collegefishies/yb-boy/imgs/code/analogPins.png

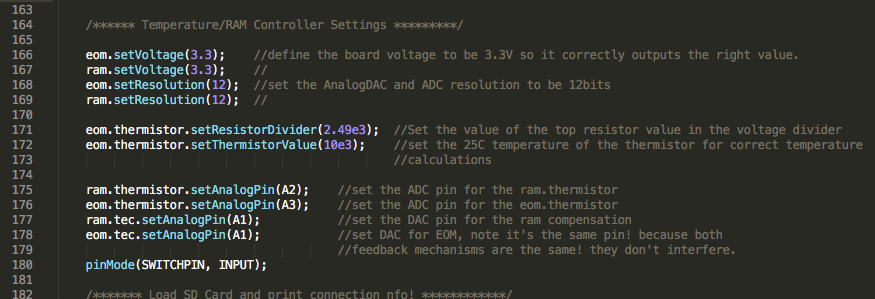
imgs/code/analogPins.png
