collegefishies/yb-boy/imgs/code/controller_classes.png

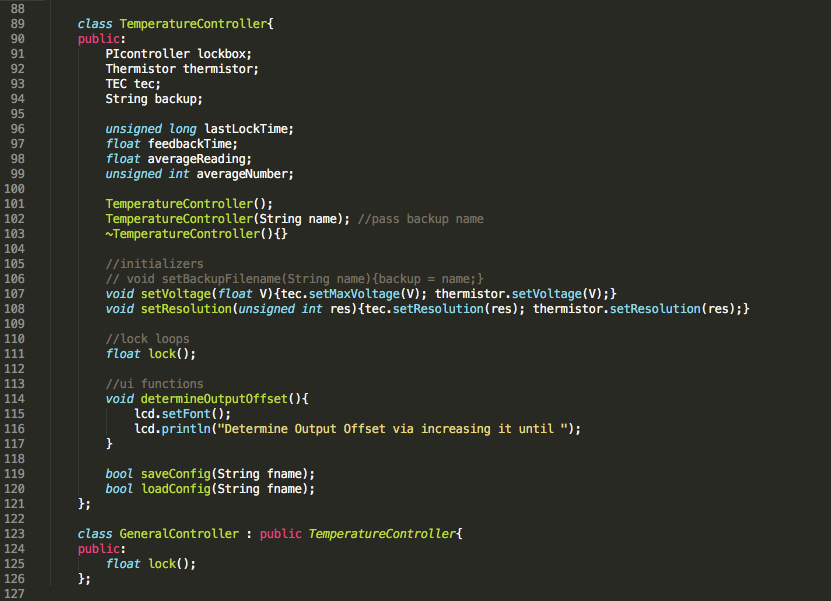
imgs/code/controller_classes.png
