collegefishies/yb-boy/(threads)

Thread 1 (2019-06-03):

Continuity Issue with commit b8b2317da

collegefishies, 2019-06-03:
Switching from TMP mode to RAM mode doesn't properly preserve continuity.

Initial drive was 3V after switching it jumped to 5.98V. Switching back from RAM to TMP preserved that 5.98V drive.

I need to correct continuity for the temperature to ram compensation switch.

collegefishies, 2019-06-05:
Fixed continuity branch and implemented into v1.x in commit 23eb9b72d50893243ce58777a3b49c2b77cd8568

Closed 2019-06-05.
