collegefishies/yb-boy/Yb-boy-build-instructions.pdf

T

I

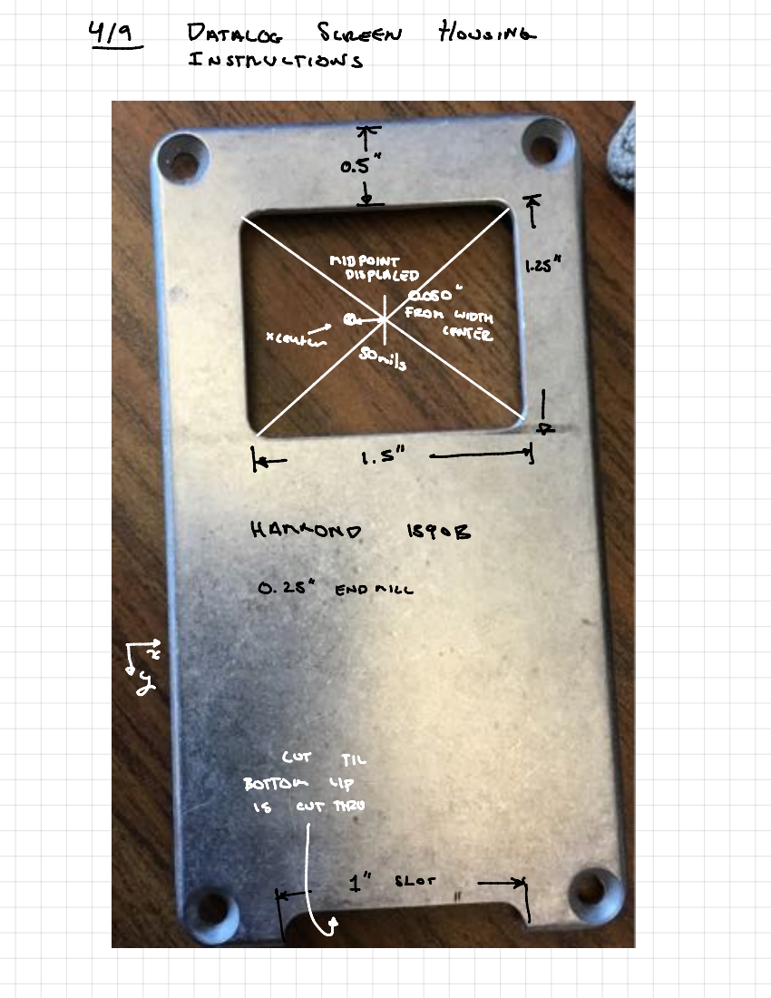
[picture p6: page 1]
DATALOG; SCREEN; HOUSING; Instructions; MIDPOINT; DISPLACED; FROM; WIDTH; CENTER center; HAMMOND; END; MILL; CUT; TIL; BOTTOM; LIP µIS; THZU; shot -4

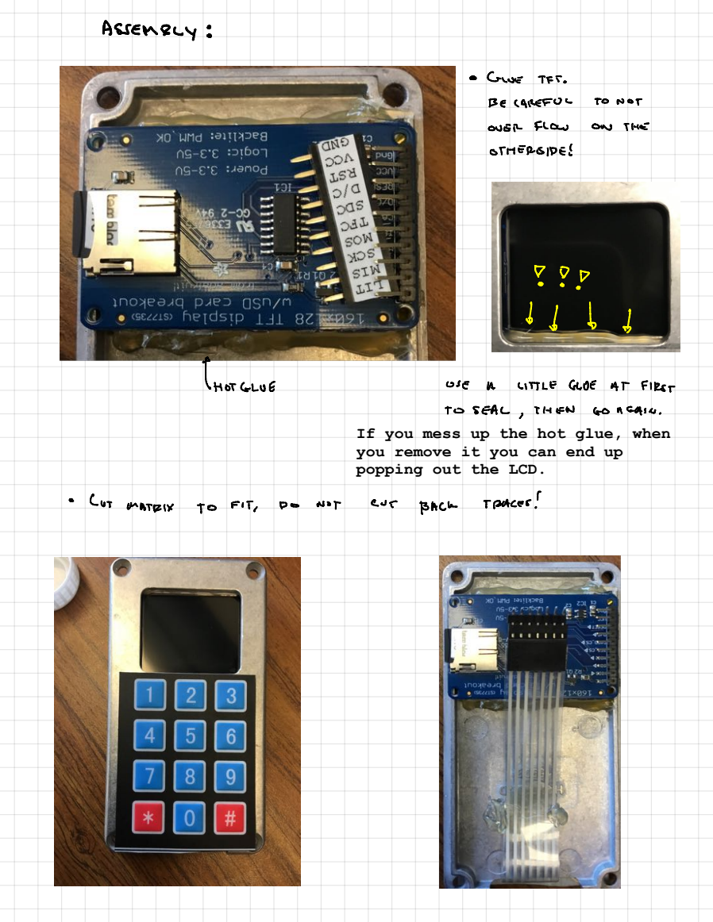
[picture p7: page 2]
If you; mess; up the; hot glue,; when; you; remove it; you can; end; popping out; the LCD.; ASSEMBLY; GLUE; CAREFUL; NOT; OVER; FLOW; TITE; OTHER; SIDE !; [ HOT; USE; LITTLE; GLOE; FIRST; SEAL; AGAIN; MATRIX; FIT; CUT; BACK; TRACES

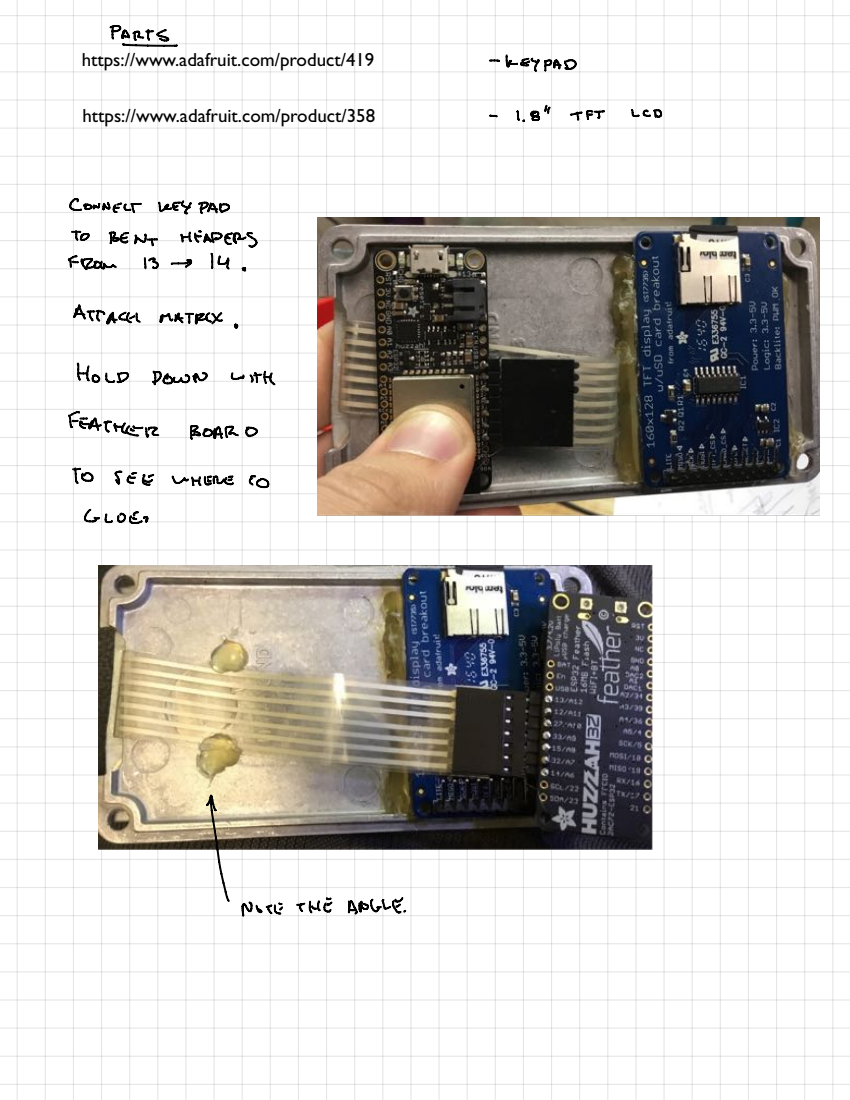
[picture p8: page 3]
KEYPAD; TFT; LCD; CONNECT; BENT; HEADERS; From; ATTACH; MATRCX; HOLD; DOWN; with; FEATHER; BOARD; SEE; WHERE; GLOEO; Note; THE; ANGLE .

Parts-
https://www.adafruit.com/product/419

https://www.adafruit.com/product/358

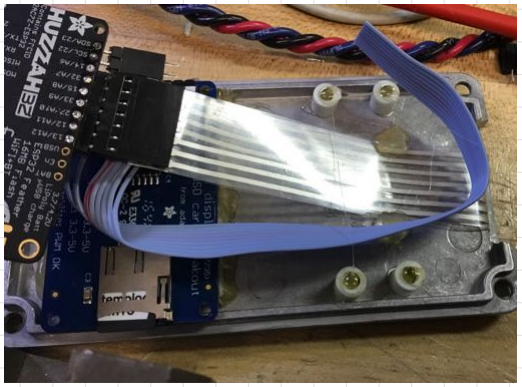
[picture p9: figure]

Solder | a | female | header
row | for connecting | to
the | TFT screen. | If | you
want, | you can | label the
header | row | via printing
a | label. | I | made | mine
using | our PTouch
printer. | I | still | have
the | file | saved. | 7.2pt
is 0.1” so | setting | the
font to 7pt | is
approximately | one PCB
spacing.
One | can use | a | ribbon
cable | for convenience

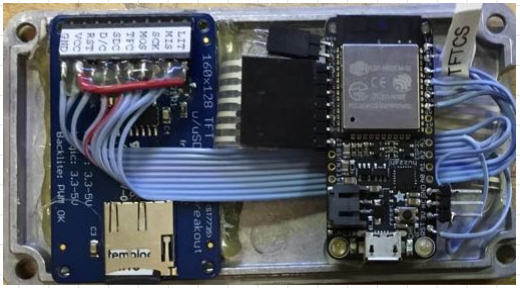
[picture p10: figure]

Attach a 3 | pin
male header for
power
distribution.
Complete! Label
the TFT_CS,
SD_CS, and D/C
pins for future
convenience and
you’re finished!
