collegefishies/yb-boy/temperatureController.h

#ifndef temperatureController_h
#define temperatureController_h

#include "lcd.h"
#include <ArduinoJson.h>
#include <SD.h>
#include "expressMem.h"

namespace temperatureController {

	class TemperatureController;
	class Thermistor;
	class TEC;
	class PIcontroller;

	class PIcontroller{
		public:
			float G;           	//total gain
			float P, I;        	//p,i,d gains
			float output;      	//output value
			float outputOffset;	//output offset
			float history;     	//float that allows for continuous drive changes.
			float input;
			float setpoint;
			float error;
			float integral;
			float dt;

			bool locked;
			
			void init(){G = P = I = output = input = history = setpoint = error = integral = dt = locked = 0;};
			void feedback();	//call this loop repeatedly
	};

	class TEC{
	public:
		unsigned int pin;
		float VCC;
		int resolution;

		void init(){pin = VCC = resolution = 0;}
		void setResolution(unsigned int res){resolution = res; analogWriteResolution(resolution);}
		void setMaxVoltage(float V){VCC = V;}
		void setAnalogPin(unsigned int analogPin){pin = analogPin;}
		void setVoltage(float V){
			analogWriteResolution(resolution);
			float integer = ((1 << resolution) - 1 )*V/VCC;
			if ( (V >= 0)){
				int set = min(int(round(integer)), (1 << resolution) - 1);
				analogWrite(pin, set);
			} else {
				analogWrite(pin, 0);
			}
		}
	};

	class Thermistor{
		public:
			unsigned int pin;
			float VCC;
			float resistance; //ohms
			float roomResistance;
			float intVal;
			int resolution;
			float averagedVoltage;
			unsigned int lastMeasureTime;
			unsigned int avgNo;

		public:

			//definer functions
			void init(){pin = VCC = resistance = roomResistance = intVal = resolution = lastMeasureTime = avgNo = averagedVoltage = 0;}
			void setResolution(unsigned int res){resolution = res; analogReadResolution(resolution);}
			void setAnalogPin(unsigned int analogPin){pin = analogPin; update();}
			void setVoltage(float voltage);  	//set voltage driving voltage divider.
			void setResistorDivider(float R);	//set value of top resistor for the voltage divider;
			// void setReadRate(float rate); 	//set rate of desired update times in number per second;
			void setThermistorValue(float R){roomResistance = R;};
			
			//utilities
			void update();                                                 	//updates intVal with reading of thermistor;
			float getVoltage();                                            	//
			float getAverageVoltage(int averages, int integrationTime);    	//
			float getResistance();                                         	//
			float getAverageResistance(int averages, int integrationTime); 	//
			float getAverageTemperature(int averages, int integrationTime);	//
		 
	};

	class TemperatureController{
	public:
		PIcontroller lockbox;
		Thermistor thermistor;
		TEC tec;
		String backup;

		unsigned long lastLockTime;
		float feedbackTime;
		float averageReading;
		unsigned int averageNumber;

		TemperatureController();
		TemperatureController(String name); //pass backup name 
		~TemperatureController(){}

		//initializers
		// void setBackupFilename(String name){backup = name;}
		void setVoltage(float V){tec.setMaxVoltage(V); thermistor.setVoltage(V);}
		void setResolution(unsigned int res){tec.setResolution(res); thermistor.setResolution(res);}

		//lock loops
		float lock();

		//ui functions
		void determineOutputOffset(){
			lcd.setFont();
			lcd.println("Determine Output Offset via increasing it until ");
		}

		bool saveConfig(String fname);
		bool loadConfig(String fname);
	};

	class GeneralController : public TemperatureController{
	public:
		float lock();
	};

}

#endif
