collegefishies/yb-boy/eomSettings.h

#define EOMPROGS 9
#define EOMBAK "TEMP_PI"
menu eomSettings;

extern temperatureController::TemperatureController eom;

namespace eomMenu {

bool setEomVar(float& x, String prompt){
	char buff[50];
	sprintf(buff, "Current value is:\n%e", x);
	lcd.println(buff);
	String temp = numInput(prompt);
	if(temp.length() == 0){
		lcd.println("No change made.");
		delay(500);
		return false;
	}

	x = temp.toFloat();
	eom.saveConfig(EOMBAK);
	return true;
}

void setVar(float& x, String prompt){
	char buff[50];
	sprintf(buff, "Current value is: %e", x);
	lcd.println(buff);
	String temp = numInput(prompt);
	if(temp.length() == 0){
		lcd.println("No change made.");
		delay(500);
		return;
	}

	x = temp.toFloat();
}

void setFeedbackTime(){setEomVar(eom.feedbackTime, "Input feedback time:\n");}
void setG(){
	float oldG = eom.lockbox.G;
	bool changed = setEomVar(eom.lockbox.G, "Input G:\n");
	if(changed){
		eom.lockbox.history += -oldG*eom.lockbox.I*eom.lockbox.integral;
		eom.lockbox.integral = 0;
	}
}
void setP(){setEomVar(eom.lockbox.P, "Input P:\n");}
void setI(){
	float oldI = eom.lockbox.I;
	bool changed = setEomVar(eom.lockbox.I, "Input I (1/s):\n"); 
	if(changed){
		eom.lockbox.history += -eom.lockbox.G*oldI*eom.lockbox.integral;
		eom.lockbox.integral = 0;
	}
}
void setSetpoint(){setEomVar(eom.lockbox.setpoint, "Input setpoint (C):\n");};
void setOutputOffset(){setEomVar(eom.lockbox.outputOffset, "Input outputOffset:\n");}

void switchFeedback(){
	eom.lockbox.G *= -1;
	eom.saveConfig(EOMBAK);
}


void toggleFeedback(){
	eom.lockbox.locked = !eom.lockbox.locked;
}

void zeroIntegrator(){
	eom.lockbox.integral = 0;
	eom.lockbox.history = 0;
	eom.saveConfig(EOMBAK);
}

void printFreeRam(){
	lcd.println("Free RAM is: ");
	lcd.println(freeMemory());
	wait();
}
void printSettings(){
	char buff[200];
	sprintf(buff, 
		"Total Gain: %.3e\nProportional: %.3f\nIntegral Gain: %.3e\nOutput Offset: %.3f\nSetpoint (C): %.3f\n",
		eom.lockbox.G, eom.lockbox.P,
		eom.lockbox.I, eom.lockbox.outputOffset,
		eom.lockbox.setpoint);
	lcd.println(buff);
	wait();
}

String settingsItems[EOMPROGS]   = {
	"Print settings",
	"Set setpoint",
	"Switch feedback sign",
	"Set the total gain G", 
	"Set proportional gain P", 
	"Set integral gain I", 
	"Set output offset",
	"Zero the integrator",
	"Set feedbackTime"
	};

void (*settingsProgs[EOMPROGS])()= {
	printSettings,
	setSetpoint, 
	switchFeedback, 
	setG, 
	setP, 
	setI, 
	setOutputOffset,
	zeroIntegrator,
	setFeedbackTime
};

}
