collegefishies/yb-boy/expressMem.cpp

#ifndef expressMem_cpp
#define expressMem_cpp

#include "expressMem.h"

#if defined(__SAMD51__)
  // Alternatively you can define and use non-SPI pins, QSPI isnt on a sercom
  Adafruit_SPIFlash flash(PIN_QSPI_SCK, PIN_QSPI_IO1, PIN_QSPI_IO0, PIN_QSPI_CS);
#else
  #if (SPI_INTERFACES_COUNT == 1)
    #define FLASH_SS       SS                    // Flash chip SS pin.
    #define FLASH_SPI_PORT SPI                   // What SPI port is Flash on?
  #else
    #define FLASH_SS       SS1                    // Flash chip SS pin.
    #define FLASH_SPI_PORT SPI1                   // What SPI port is Flash on?
  #endif

Adafruit_SPIFlash flash(FLASH_SS, &FLASH_SPI_PORT);     // Use hardware SPI
#endif

Adafruit_W25Q16BV_FatFs fatfs(flash);
#endif
