collegefishies/yb-boy/(commit log)

2019-04-28 First graph of sine wave.
    Currently only can erase 1 trace. Need to fix bitArray operator+();
    Must add window limits.
    [M4tempController.ino, graph.cpp, graph.h]
2019-04-28 Revert "implemented setXlims, setYlims"
    This reverts commit 4e45f7018897d1361a7bbd0743467726506c3c56.
    [M4tempController.ino, bitArray.cpp, graph.cpp, graph.h]
2019-04-29 Working Grid. Alloc and operator+ bug fixed in bitArray.cpp
    [M4tempController.ino, bitArray.cpp, bitArray.h, graph.cpp]
2019-04-29 Got graph to not crash. Fixed lot of bitArray bugs. Mostly, numberOfBytes not updating in constructors. Operator+ should add. Either the adding or the assingnment of the sum needs to be fixed.
    [M4tempController.ino, bitArray.cpp, bitArray.h, graph.cpp]
2019-04-30 Set averageTime to total time in thermistor class. Made PI controller w/ default constructors.
2019-04-30 Fixed error in set voltage. No more wraparound.
    [M4tempController.ino, temperatureController.h]
2019-04-30 Create TemperatureController class.
2019-05-01 Remove old config file before writing to prevent needless append.
    [temperatureController.cpp]
2019-05-02 Set .ino to arduino example.
2019-05-02 Add feedback toggle (ram.lockbox.locked). Add setFeedbackTime to settings. Set millis() vars to unsigned longs. Made tempController return nans if there is no feedback. Delayed plotting to every seco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
2019-05-02 Add printFreeRam, toggleFeedback, setYlims to 20->70.
2019-05-02 Add non quitting 10kHz on A0 for testing output noise, and speed.
    [M4tempController.ino]
2019-05-09 Add rotateScreenUI(), printPinOuts(), activate on SWITCHPIN
2019-05-18 add temperature measure to ram lock.
2019-05-18 index on nonBlockingTempMeasure: 483e83a add temperature measure to ram lock.
2019-05-18 Add global variables for non blocking temperature average in thermistor. Modify averaging function to be non blocking. Added safety check in controller classes to not run on nan measurements.
2019-05-21 Force integrator reset when integral gain changes.
    [M4tempController.ino, eomSettings.h, ramSettings.h]
2019-05-21 Fix non-blocking averageTemp bug, where output reading would be set to zero before returning.
    [temperatureController.cpp]
2019-05-21 Add setVoltage to isnan check in temperatureController::lock();
2019-05-21 Add feedbackTime to save/loadConfig in temperatureController.cpp.
2019-05-21 Made TemperatureController/GeneralController lock compatible with non blocking average.
2019-05-21 Made printMode print on menuExit and program start.
2019-05-21 Changed Output graph to plot current outputted value for ram or temp.
2019-05-22 Update RAM menu setpoint units to volts.
2019-05-22 Fix uncomment memoryFree.h - thanks joon.
    [M4tempController.ino]
2019-05-31 UNTESTED: Forced integrator times to switch to zero when you switch between locks, so there isn't huge integrated errors when switching between locks!
    [M4tempController.ino]
2019-05-31 Add history variable to temperatureController and generalController. It's essentially a second outputOffset that the user can tune as desired.
2019-05-31 UNTESTED: Ensure outputs are continuous on lock switch.
2019-05-31 UNTESTED: Implement continuity in PI settings change for eom temperature controller.
2019-06-04 Attempted bugfix for Issue #1. I'm assuming the bug is caused by the fact that ram.lockbox.output is not initially defined on progstart.
    [M4tempController.ino]
2019-06-04 Attempted bugfix for Issue #1. Apparently activateRamFeedbac was already defined in a way as to make the switch continuous. I was doubling up, on that switch and going way to high on the output. This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
    [M4tempController.ino]
2019-06-04 Revert "TESTED(Success!): Implement continuity in PI settings change for RAM lock."
    This reverts commit 96609a3b71cb9d5d4eaefa28fa24f68a18165b5c.
    [ramSettings.h]
